tsmith512/88-D21-brake-line-bracket/brake-bracket.stl

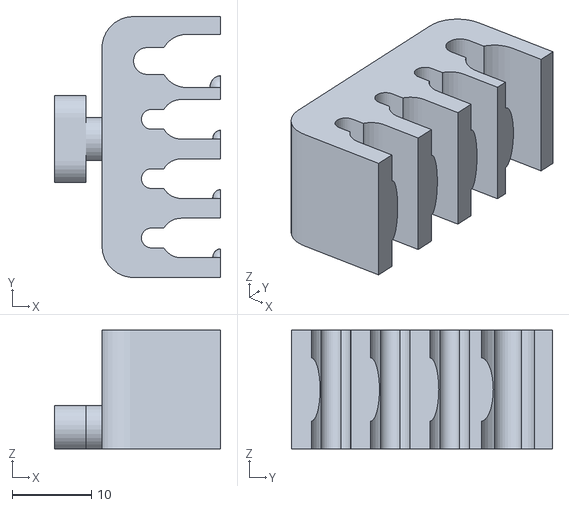
[picture p1: CAD file, 2017-01-11]
brake-bracket.stl
21.0 x 33.0 x 15.0
