tsmith512/88-D21-brake-line-bracket/(commit log)

2017-01-04 Back clip rectangle, initial commit
    [brake-bracket.scad]
2017-01-04 Round the back corners off and wrap it as a module
    [brake-bracket.scad]
2017-01-04 Set up a repeatable channel for a single line
    [brake-bracket.scad]
2017-01-04 Oops. Wrong dimension.
    [brake-bracket.scad]
2017-01-04 Set up 4 brake line channels side by side in a group and subtract them from the bracket
    [brake-bracket.scad]
2017-01-04 First stab at the support clip
    [brake-bracket.scad]
2017-01-04 Add some additional wings to the tabs
    [brake-bracket.scad]
2017-01-04 Attach the support/clip to the back of the bracket
    [brake-bracket.scad]
2017-01-11 Version 1: Three of four channels fit; fourth is a vacuum line. Mounting bracket/tabs didn't work well.
    [brake-bracket.stl]
2017-01-11 Make the fourth channel wider because it's a vacuum line (I think...) not a brake line; it is slightly wider.
    [brake-bracket.scad]
2017-01-11 Well this sure was easier to write... swap the clip business for a simple rounded rectangle.
    [brake-bracket.scad]
2017-01-11 Manually calculating overlaps to ensure complete differences is unnecessary; that was just a quick rendering artifact in Preview, not Render.
    [brake-bracket.scad]
2017-01-11 Yeah that's cool and all being in mid-air like that, but that won't print well.
    [brake-bracket.scad]
2017-01-11 Version 2: Replaced attachment with a twist-in tab, all four lines now fit in their channels
    [brake-bracket.stl]
2017-01-11 Add a bump along the edge of each channel to try and hold the line in place
    [brake-bracket.scad]
2017-01-11 Version 3: Lines are held in place, but snaps could be bigger. Skirt, not brim is the best way to print this.
    [brake-bracket.stl]
2017-01-11 Make those channel snaps a little beefier
    [brake-bracket.scad]
2017-01-11 Widen that back tab, it's a little loose, I'd rather have to fight it in there than risk it falling out
    [brake-bracket.scad]
2017-01-11 Version 4: Back cap and the channel bumps all fit more snugly. Gonna print a set to install and see how they hold up for a while.
    [brake-bracket.stl]
